cculpepper/ButterflyBadge/software/python_gif_to_code/trees.gif

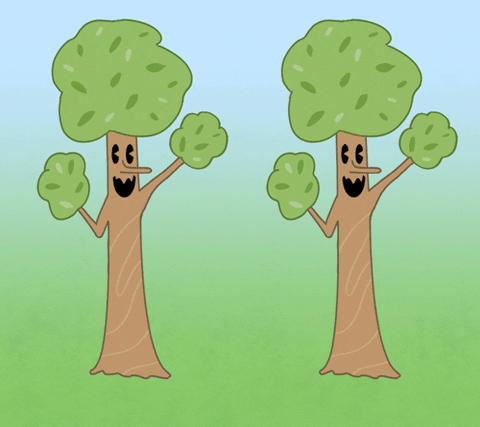
software/python_gif_to_code/trees.gif
