cculpepper/ButterflyBadge/software/python_gif_to_code/scrolling_rainbow.gif

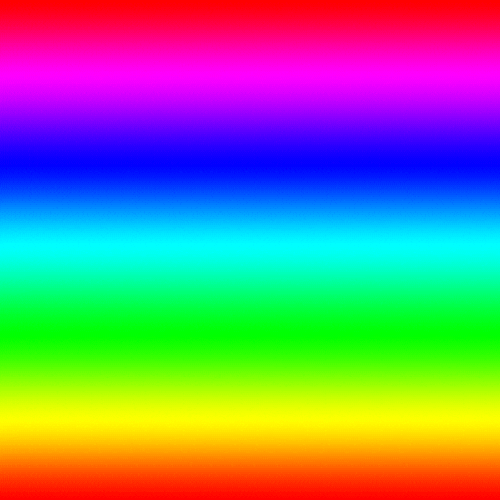
software/python_gif_to_code/scrolling_rainbow.gif
