cculpepper/ButterflyBadge/Hardware/StarboardWing/screenshotKegan.png

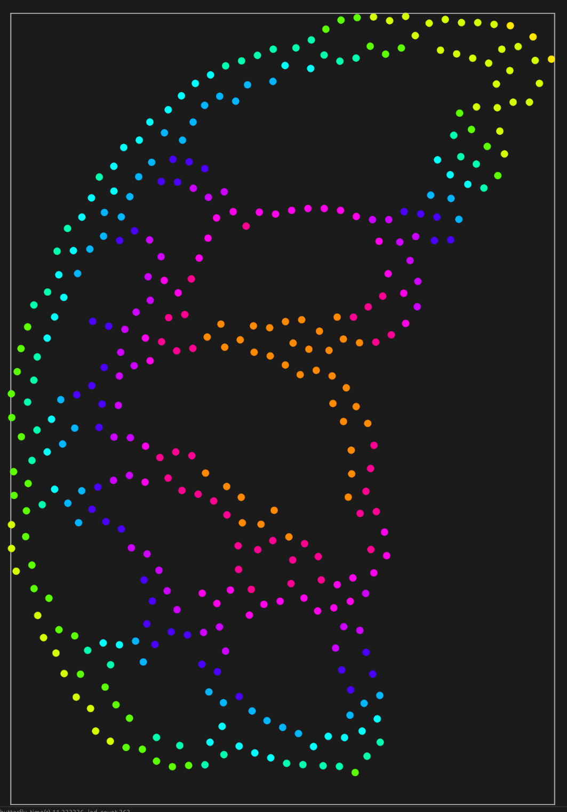
Hardware/StarboardWing/screenshotKegan.png
