cculpepper/ButterflyBadge/software/python_gif_to_code/bear.gif

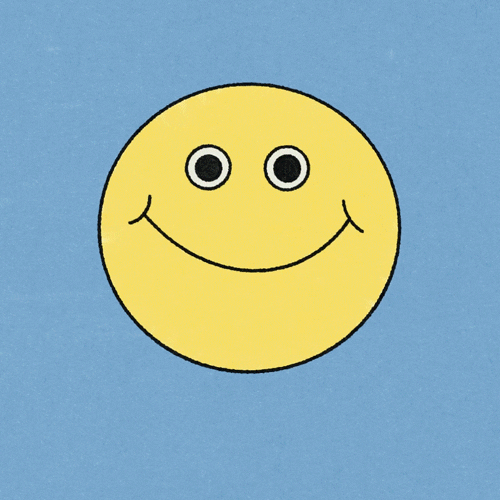
software/python_gif_to_code/bear.gif
