cculpepper/ButterflyBadge/software/python_gif_to_code/gif/myimage.gif

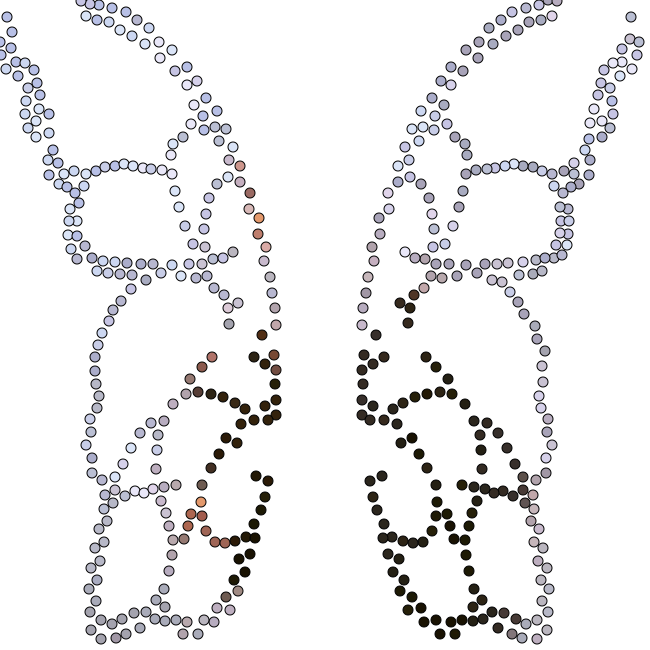
software/python_gif_to_code/gif/myimage.gif
