cculpepper/ButterflyBadge/Hardware/3D-Models/WholeBadge.FCStd

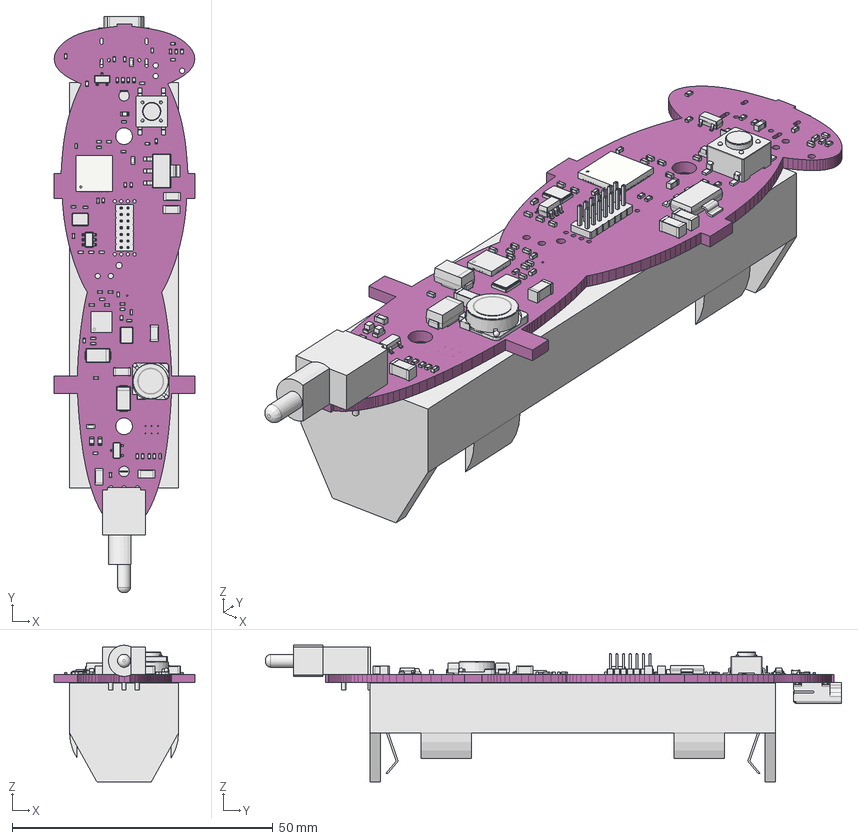
[picture p6: CAD file, 2022-10-18]
Hardware/3D-Models/WholeBadge.FCStd
26.9 x 110.4 x 26.2 mm
Pcb_931
R21_C_0402_1005Metric_38c94f1f1ba7 x 30
R19_R_0402_1005Metric_9ca80ee487fc x 22
D2_D_SMA_34cf3897dfc1 x 2
C42_C_0603_1608Metric_3f0e18eb3bdb x 3
SW3_Fillet_54ad2342c7e7
U5_SOT_223_0bc22c24d438
C44_C_1206_3216Metric_504a53cc2dd0 x 6
U6_QFN-20-1EP_4x4mm_Pitch0.5mm_3f7a39cb167c
L3_L_0402_1005Metric_7322f57e24a3 x 3
D516_LED_0603_1608Metric_23db4c450fc7 x 3
U8_SOT_23_1e3b1a0e5d43 x 2
U3_QFN_56_1EP_7x7mm_P04mm_EP32x32mm_92a982e71d8d
Y1_Crystal_SMD_3225-4Pin_3.2x2.5mm_5bc66405eca2 x 2
J4_PinHeader_2x07_P127mm_Vertical_bf31e59c633b
U9_SOT_23_6_c7a49d86fbfe
SW1_SW_SPST_PTS645_03fdbfd9ae36
L1_Sf㱟fd_sp_e828286b0ac3
BT1_MPD_BH_18650_PC2_17c3f7ae5d37
J1_USB_Mini-B_Lumberg_2486_01_Horizontal_f06c414dff7d
