cculpepper/ButterflyBadge/Hardware/3D-Models/StarboardWing.FCStd

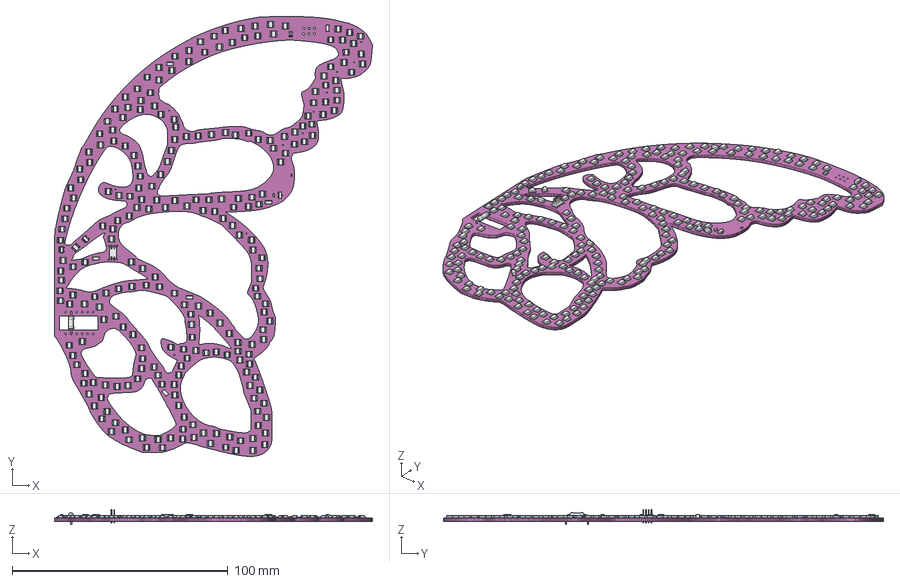
[picture p7: CAD file, 2022-10-22]
Hardware/3D-Models/StarboardWing.FCStd
147.4 x 203.9 x 7.00 mm
Pcb_1785
D136_LED_RGB_1210_62a520bec992 x 247
U4_SOT_23_5_fc069c77c7b4 x 2
C2_C_1206_3216Metric_b79cb4619a35 x 6
C3_C_0603_1608Metric_700197c864c6 x 3
U1_SOT_23_4b6a6773a716
J1_PinHeader_2x04_P127mm_Vertical_bbcf534692e7
J14_R_Axial_DIN0207_L63mm_D25mm_P1016mm_Horizontal_16070ee27b5d
C1_C_0402_1005Metric_dadc7bec6630
