cculpepper/ButterflyBadge/Hardware/wingHinge.FCStd

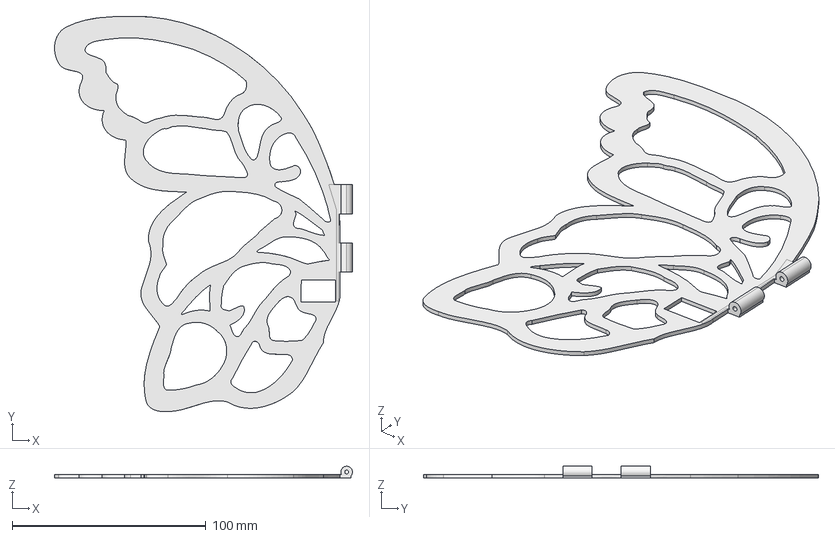
[picture p8: CAD file, 2022-12-04]
Hardware/wingHinge.FCStd
153.7 x 203.9 x 6.00 mm
