cculpepper/ButterflyBadge/Hardware/centerHinge.FCStd

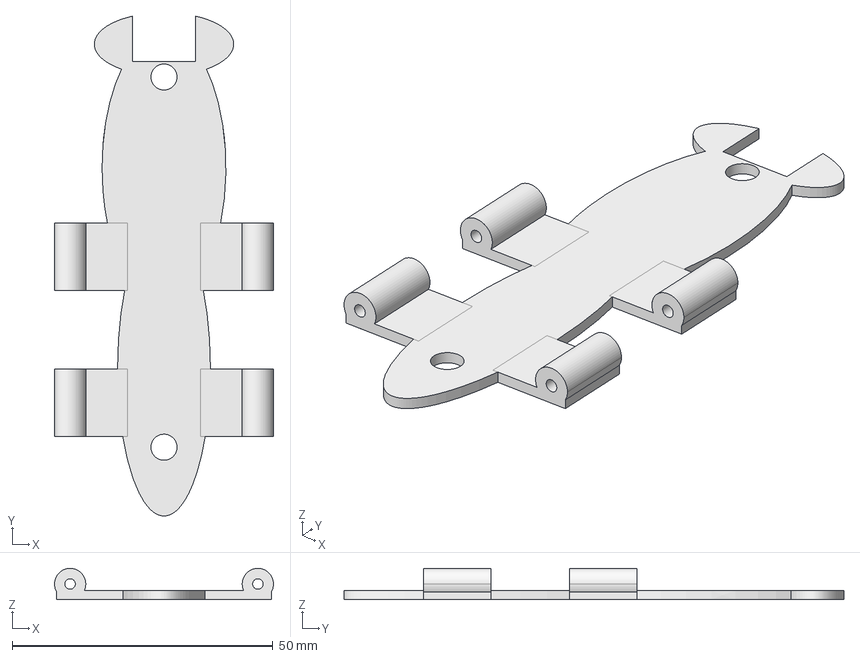
[picture p9: CAD file, 2022-12-04]
Hardware/centerHinge.FCStd
42.0 x 95.9 x 6.00 mm
