cculpepper/ButterflyBadge/(list of files, cad)

Other CAD files:
Hardware/hingeTestAssembly.FCStd
Hardware/ButterflyBadge/outline.FCStd
Hardware/3D-Models/centerWing.FCStd
Hardware/3D-Models/centerBoard.FCStd
Hardware/WingTest.FCStd
