cculpepper/ButterflyBadge/Hardware/PortWing/PortWing.kicad_pcb

## KiCad design Hardware/PortWing/PortWing.kicad_pcb (2022-10-20)

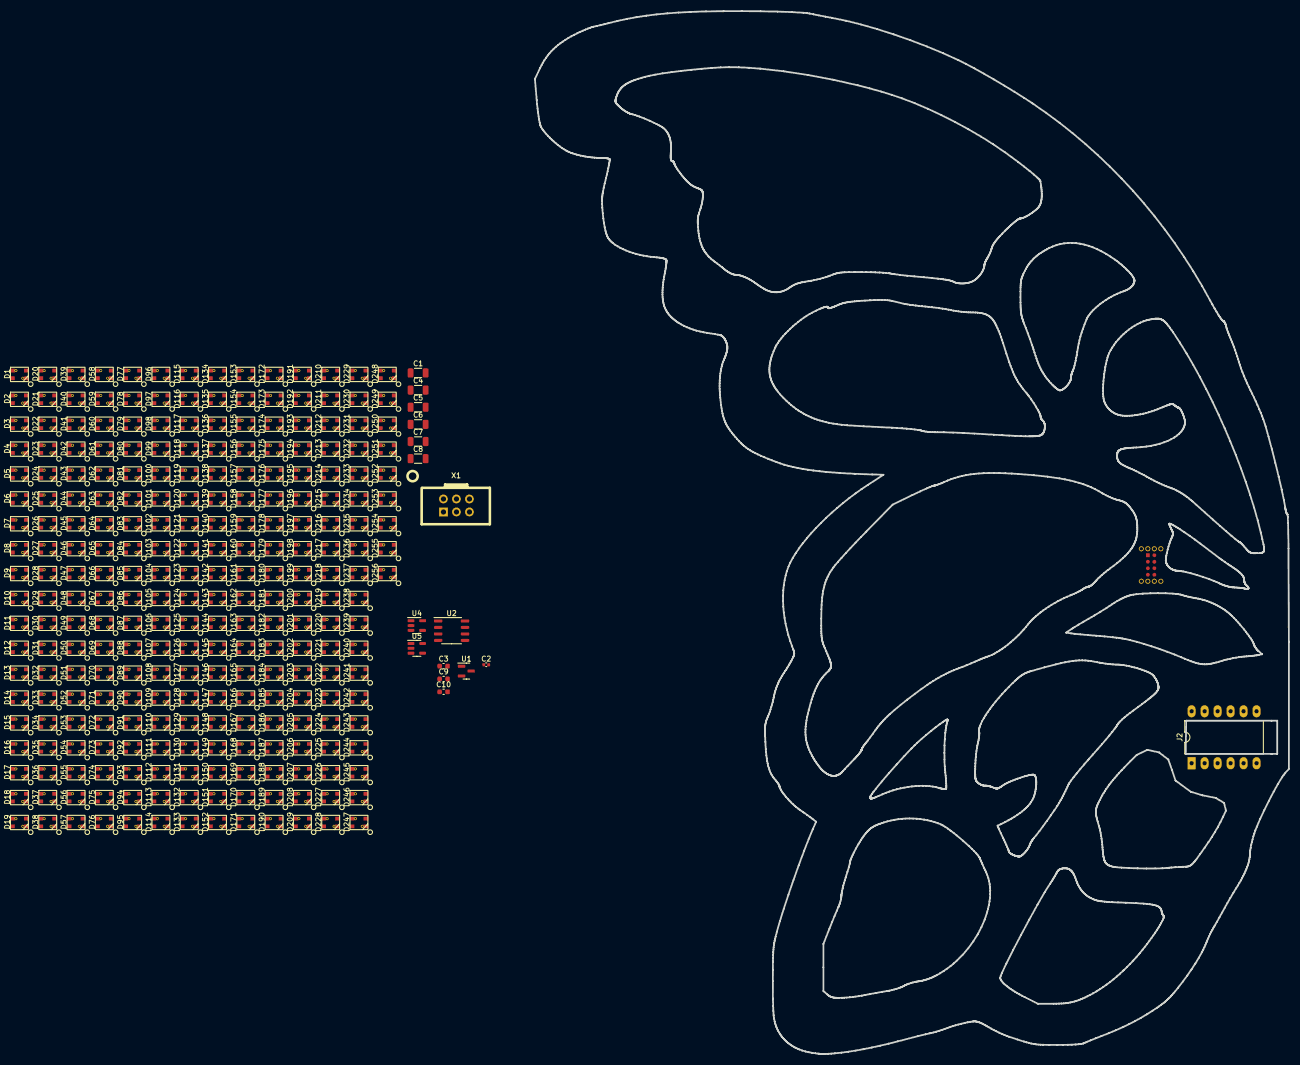
[picture p11: board PortWing.kicad_pcb from above]

Board: 2 copper layers, 147.4 x 203.9 mm, 273 parts (0 on the bottom side), 265 nets, no tracks yet.

Parts:
C1, C4, C5, C6, C7, C8: 22uF; C_1206_3216Metric
C2: 1uF; C_0402_1005Metric
C3, C9, C10: 10uF; C_0603_1608Metric
D1, D2, D3, D4, D5, D6, D7, D8, D9, D10, D11, D12, D13, D14, D15, D16, D17, D18, D19, D20, D21, D22, D23, D24, D25, D26, D27, D28, D29, D30, D31, D32, D33, D34, D35, D36, D37, D38, D39, D40, D41, D42, D43, D44, D45, D46, D47, D48, D49, D50, D51, D52, D53, D54, D55, D56, D57, D58, D59, D60, D61, D62, D63, D64, D65, D66, D67, D68, D69, D70, D71, D72, D73, D74, D75, D76, D77, D78, D79, D80, D81, D82, D83, D84, D85, D86, D87, D88, D89, D90, D91, D92, D93, D94, D95, D96, D97, D98, D99, D100, D101, D102, D103, D104, D105, D106, D107, D108, D109, D110, D111, D112, D113, D114, D115, D116, D117, D118, D119, D120, D121, D122, D123, D124, D125, D126, D127, D128, D129, D130, D131, D132, D133, D134, D135, D136, D137, D138, D139, D140, D141, D142, D143, D144, D145, D146, D147, D148, D149, D150, D151, D152, D153, D154, D155, D156, D157, D158, D159, D160, D161, D162, D163, D164, D165, D166, D167, D168, D169, D170, D171, D172, D173, D174, D175, D176, D177, D178, D179, D180, D181, D182, D183, D184, D185, D186, D187, D188, D189, D190, D191, D192, D193, D194, D195, D196, D197, D198, D199, D200, D201, D202, D203, D204, D205, D206, D207, D208, D209, D210, D211, D212, D213, D214, D215, D216, D217, D218, D219, D220, D221, D222, D223, D224, D225, D226, D227, D228, D229, D230, D231, D232, D233, D234, D235, D236, D237, D238, D239, D240, D241, D242, D243, D244, D245, D246, D247, D248, D249, D250, D251, D252, D253, D254, D255, D256: SK6812; XL-3528RGBW
J1: Conn_02x04_Odd_Even; FlatFlexWingConnector-WingPCBSide
J2: Conn_02x06_Counter_Clockwise; DIP-12_W10.16mm_LongPads
U1: XC6206PxxxMR; SOT-23
U2: SOP-8_3.9x4.9mm_P1.27mm
U4, U5: SN74LV1T34DBV; SOT-23-5
X1: Badgelife_sao_connector_v169bis; Badgelife-SAOv169-BADGE-2x3

Connections:
/3V3: C2.1, C3.1, C9.1, C10.1, U1.2 (VO), U2.1 (V_EH), U2.8 (VCC), X1.1 (VCC)
/5V: C1.1, C4.1, C5.1, C6.1, C7.1, C8.1, D1.3 (VDD), D2.3 (VDD), D3.3 (VDD), D4.3 (VDD), D5.3 (VDD), D6.3 (VDD), D7.3 (VDD), D8.3 (VDD), D9.3 (VDD), D10.3 (VDD), D11.3 (VDD), D12.3 (VDD), D13.3 (VDD), D14.3 (VDD), D15.3 (VDD), D16.3 (VDD), D17.3 (VDD), D18.3 (VDD), D19.3 (VDD), D20.3 (VDD), D21.3 (VDD), D22.3 (VDD), D23.3 (VDD), D24.3 (VDD), D25.3 (VDD), D26.3 (VDD), D27.3 (VDD), D28.3 (VDD), D29.3 (VDD), D30.3 (VDD), D31.3 (VDD), D32.3 (VDD), D33.3 (VDD), D34.3 (VDD), D35.3 (VDD), D36.3 (VDD), D37.3 (VDD), D38.3 (VDD), D39.3 (VDD), D40.3 (VDD), D41.3 (VDD), D42.3 (VDD), D43.3 (VDD), D44.3 (VDD), D45.3 (VDD), D46.3 (VDD), D47.3 (VDD), D48.3 (VDD), D49.3 (VDD), D50.3 (VDD), D51.3 (VDD), D52.3 (VDD), D53.3 (VDD), D54.3 (VDD), D55.3 (VDD), D56.3 (VDD), D57.3 (VDD), D58.3 (VDD), D59.3 (VDD), D60.3 (VDD), D61.3 (VDD), D62.3 (VDD), D63.3 (VDD), D64.3 (VDD), D65.3 (VDD), D66.3 (VDD), D67.3 (VDD), D68.3 (VDD), D69.3 (VDD), D70.3 (VDD), D71.3 (VDD), D72.3 (VDD), D73.3 (VDD), D74.3 (VDD), D75.3 (VDD), D76.3 (VDD), D77.3 (VDD), D78.3 (VDD), D79.3 (VDD), D80.3 (VDD), D81.3 (VDD), D82.3 (VDD), D83.3 (VDD), D84.3 (VDD), D85.3 (VDD), D86.3 (VDD), D87.3 (VDD), D88.3 (VDD), D89.3 (VDD), D90.3 (VDD), D91.3 (VDD), D92.3 (VDD), D93.3 (VDD), D94.3 (VDD), D95.3 (VDD), D96.3 (VDD), D97.3 (VDD), D98.3 (VDD), D99.3 (VDD), D100.3 (VDD), D101.3 (VDD), D102.3 (VDD), D103.3 (VDD), D104.3 (VDD), D105.3 (VDD), D106.3 (VDD), D107.3 (VDD), D108.3 (VDD), D109.3 (VDD), D110.3 (VDD), D111.3 (VDD), D112.3 (VDD), D113.3 (VDD), D114.3 (VDD), D115.3 (VDD), D116.3 (VDD), D117.3 (VDD), D118.3 (VDD), D119.3 (VDD), D120.3 (VDD), D121.3 (VDD), D122.3 (VDD), D123.3 (VDD), D124.3 (VDD), D125.3 (VDD), D126.3 (VDD), D127.3 (VDD), D128.3 (VDD), D129.3 (VDD), D130.3 (VDD), D131.3 (VDD), D132.3 (VDD), D133.3 (VDD), D134.3 (VDD), D135.3 (VDD), D136.3 (VDD), D137.3 (VDD), D138.3 (VDD), D139.3 (VDD), D140.3 (VDD), D141.3 (VDD), D142.3 (VDD), D143.3 (VDD), D144.3 (VDD), D145.3 (VDD), D146.3 (VDD), D147.3 (VDD), D148.3 (VDD), D149.3 (VDD), D150.3 (VDD), D151.3 (VDD), D152.3 (VDD), D153.3 (VDD), D154.3 (VDD), D155.3 (VDD), D156.3 (VDD), D157.3 (VDD), D158.3 (VDD), D159.3 (VDD), D160.3 (VDD), D161.3 (VDD), D162.3 (VDD), D163.3 (VDD), D164.3 (VDD), D165.3 (VDD), D166.3 (VDD), D167.3 (VDD), D168.3 (VDD), D169.3 (VDD), D170.3 (VDD), D171.3 (VDD), D172.3 (VDD), D173.3 (VDD), D174.3 (VDD), D175.3 (VDD), D176.3 (VDD), D177.3 (VDD), D178.3 (VDD), D179.3 (VDD), D180.3 (VDD), D181.3 (VDD), D182.3 (VDD), D183.3 (VDD), D184.3 (VDD), D185.3 (VDD), D186.3 (VDD), D187.3 (VDD), D188.3 (VDD), D189.3 (VDD), D190.3 (VDD), D191.3 (VDD), D192.3 (VDD), D193.3 (VDD), D194.3 (VDD), D195.3 (VDD), D196.3 (VDD), D197.3 (VDD), D198.3 (VDD), D199.3 (VDD), D200.3 (VDD), D201.3 (VDD), D202.3 (VDD), D203.3 (VDD), D204.3 (VDD), D205.3 (VDD), D206.3 (VDD), D207.3 (VDD), D208.3 (VDD), D209.3 (VDD), D210.3 (VDD), D211.3 (VDD), D212.3 (VDD), D213.3 (VDD), D214.3 (VDD), D215.3 (VDD), D216.3 (VDD), D217.3 (VDD), D218.3 (VDD), D219.3 (VDD), D220.3 (VDD), D221.3 (VDD), D222.3 (VDD), D223.3 (VDD), D224.3 (VDD), D225.3 (VDD), D226.3 (VDD), D227.3 (VDD), D228.3 (VDD), D229.3 (VDD), D230.3 (VDD), D231.3 (VDD), D232.3 (VDD), D233.3 (VDD), D234.3 (VDD), D235.3 (VDD), D236.3 (VDD), D237.3 (VDD), D238.3 (VDD), D239.3 (VDD), D240.3 (VDD), D241.3 (VDD), D242.3 (VDD), D243.3 (VDD), D244.3 (VDD), D245.3 (VDD), D246.3 (VDD), D247.3 (VDD), D248.3 (VDD), D249.3 (VDD), D250.3 (VDD), D251.3 (VDD), D252.3 (VDD), D253.3 (VDD), D254.3 (VDD), D255.3 (VDD), D256.3 (VDD), J1.1, U1.3 (VI), U4.5 (VCC), U5.5 (VCC)
/GND: C1.2, C2.2, C3.2, C4.2, C5.2, C6.2, C7.2, C8.2, C9.2, C10.2, D1.1 (VSS), D2.1 (VSS), D3.1 (VSS), D4.1 (VSS), D5.1 (VSS), D6.1 (VSS), D7.1 (VSS), D8.1 (VSS), D9.1 (VSS), D10.1 (VSS), D11.1 (VSS), D12.1 (VSS), D13.1 (VSS), D14.1 (VSS), D15.1 (VSS), D16.1 (VSS), D17.1 (VSS), D18.1 (VSS), D19.1 (VSS), D20.1 (VSS), D21.1 (VSS), D22.1 (VSS), D23.1 (VSS), D24.1 (VSS), D25.1 (VSS), D26.1 (VSS), D27.1 (VSS), D28.1 (VSS), D29.1 (VSS), D30.1 (VSS), D31.1 (VSS), D32.1 (VSS), D33.1 (VSS), D34.1 (VSS), D35.1 (VSS), D36.1 (VSS), D37.1 (VSS), D38.1 (VSS), D39.1 (VSS), D40.1 (VSS), D41.1 (VSS), D42.1 (VSS), D43.1 (VSS), D44.1 (VSS), D45.1 (VSS), D46.1 (VSS), D47.1 (VSS), D48.1 (VSS), D49.1 (VSS), D50.1 (VSS), D51.1 (VSS), D52.1 (VSS), D53.1 (VSS), D54.1 (VSS), D55.1 (VSS), D56.1 (VSS), D57.1 (VSS), D58.1 (VSS), D59.1 (VSS), D60.1 (VSS), D61.1 (VSS), D62.1 (VSS), D63.1 (VSS), D64.1 (VSS), D65.1 (VSS), D66.1 (VSS), D67.1 (VSS), D68.1 (VSS), D69.1 (VSS), D70.1 (VSS), D71.1 (VSS), D72.1 (VSS), D73.1 (VSS), D74.1 (VSS), D75.1 (VSS), D76.1 (VSS), D77.1 (VSS), D78.1 (VSS), D79.1 (VSS), D80.1 (VSS), D81.1 (VSS), D82.1 (VSS), D83.1 (VSS), D84.1 (VSS), D85.1 (VSS), D86.1 (VSS), D87.1 (VSS), D88.1 (VSS), D89.1 (VSS), D90.1 (VSS), D91.1 (VSS), D92.1 (VSS), D93.1 (VSS), D94.1 (VSS), D95.1 (VSS), D96.1 (VSS), D97.1 (VSS), D98.1 (VSS), D99.1 (VSS), D100.1 (VSS), D101.1 (VSS), D102.1 (VSS), D103.1 (VSS), D104.1 (VSS), D105.1 (VSS), D106.1 (VSS), D107.1 (VSS), D108.1 (VSS), D109.1 (VSS), D110.1 (VSS), D111.1 (VSS), D112.1 (VSS), D113.1 (VSS), D114.1 (VSS), D115.1 (VSS), D116.1 (VSS), D117.1 (VSS), D118.1 (VSS), D119.1 (VSS), D120.1 (VSS), D121.1 (VSS), D122.1 (VSS), D123.1 (VSS), D124.1 (VSS), D125.1 (VSS), D126.1 (VSS), D127.1 (VSS), D128.1 (VSS), D129.1 (VSS), D130.1 (VSS), D131.1 (VSS), D132.1 (VSS), D133.1 (VSS), D134.1 (VSS), D135.1 (VSS), D136.1 (VSS), D137.1 (VSS), D138.1 (VSS), D139.1 (VSS), D140.1 (VSS), D141.1 (VSS), D142.1 (VSS), D143.1 (VSS), D144.1 (VSS), D145.1 (VSS), D146.1 (VSS), D147.1 (VSS), D148.1 (VSS), D149.1 (VSS), D150.1 (VSS), D151.1 (VSS), D152.1 (VSS), D153.1 (VSS), D154.1 (VSS), D155.1 (VSS), D156.1 (VSS), D157.1 (VSS), D158.1 (VSS), D159.1 (VSS), D160.1 (VSS), D161.1 (VSS), D162.1 (VSS), D163.1 (VSS), D164.1 (VSS), D165.1 (VSS), D166.1 (VSS), D167.1 (VSS), D168.1 (VSS), D169.1 (VSS), D170.1 (VSS), D171.1 (VSS), D172.1 (VSS), D173.1 (VSS), D174.1 (VSS), D175.1 (VSS), D176.1 (VSS), D177.1 (VSS), D178.1 (VSS), D179.1 (VSS), D180.1 (VSS), D181.1 (VSS), D182.1 (VSS), D183.1 (VSS), D184.1 (VSS), D185.1 (VSS), D186.1 (VSS), D187.1 (VSS), D188.1 (VSS), D189.1 (VSS), D190.1 (VSS), D191.1 (VSS), D192.1 (VSS), D193.1 (VSS), D194.1 (VSS), D195.1 (VSS), D196.1 (VSS), D197.1 (VSS), D198.1 (VSS), D199.1 (VSS), D200.1 (VSS), D201.1 (VSS), D202.1 (VSS), D203.1 (VSS), D204.1 (VSS), D205.1 (VSS), D206.1 (VSS), D207.1 (VSS), D208.1 (VSS), D209.1 (VSS), D210.1 (VSS), D211.1 (VSS), D212.1 (VSS), D213.1 (VSS), D214.1 (VSS), D215.1 (VSS), D216.1 (VSS), D217.1 (VSS), D218.1 (VSS), D219.1 (VSS), D220.1 (VSS), D221.1 (VSS), D222.1 (VSS), D223.1 (VSS), D224.1 (VSS), D225.1 (VSS), D226.1 (VSS), D227.1 (VSS), D228.1 (VSS), D229.1 (VSS), D230.1 (VSS), D231.1 (VSS), D232.1 (VSS), D233.1 (VSS), D234.1 (VSS), D235.1 (VSS), D236.1 (VSS), D237.1 (VSS), D238.1 (VSS), D239.1 (VSS), D240.1 (VSS), D241.1 (VSS), D242.1 (VSS), D243.1 (VSS), D244.1 (VSS), D245.1 (VSS), D246.1 (VSS), D247.1 (VSS), D248.1 (VSS), D249.1 (VSS), D250.1 (VSS), D251.1 (VSS), D252.1 (VSS), D253.1 (VSS), D254.1 (VSS), D255.1 (VSS), D256.1 (VSS), J1.3, U1.1 (GND), U2.4 (VSS), U4.3 (GND), U5.3 (GND), X1.2 (GND)
/NFC_MSG: J1.8, U2.7 (GP0), X1.6 (GPIO2)
/PORT_GP0: J1.6, X1.5 (GPIO1)
/PORT_LED_1: J1.2, U4.2 (A)
/PORT_LED_2: J1.4, U5.2 (A)
/SCL: J1.5, U2.6 (SCL), X1.4 (SCL)
/SDA: J1.7, U2.5 (SDA), X1.3 (SDA)
unnamed: D1.2 (DIN), U4.4 (Y)
unnamed: D1.4 (DOUT), D2.2 (DIN)
unnamed: D2.4 (DOUT), D3.2 (DIN)
unnamed: D3.4 (DOUT), D4.2 (DIN)
unnamed: D4.4 (DOUT), D5.2 (DIN)
unnamed: D5.4 (DOUT), D6.2 (DIN)
unnamed: D6.4 (DOUT), D7.2 (DIN)
unnamed: D7.4 (DOUT), D8.2 (DIN)
unnamed: D8.4 (DOUT), D9.2 (DIN)
unnamed: D9.4 (DOUT), D10.2 (DIN)
unnamed: D10.4 (DOUT), D11.2 (DIN)
unnamed: D11.4 (DOUT), D12.2 (DIN)
unnamed: D12.4 (DOUT), D13.2 (DIN)
unnamed: D13.4 (DOUT), D14.2 (DIN)
unnamed: D14.4 (DOUT), D15.2 (DIN)
unnamed: D15.4 (DOUT), D16.2 (DIN)
unnamed: D16.4 (DOUT), D17.2 (DIN)
unnamed: D17.4 (DOUT), D18.2 (DIN)
unnamed: D18.4 (DOUT), D19.2 (DIN)
unnamed: D19.4 (DOUT), D20.2 (DIN)
unnamed: D20.4 (DOUT), D21.2 (DIN)
unnamed: D21.4 (DOUT), D22.2 (DIN)
unnamed: D22.4 (DOUT), D23.2 (DIN)
unnamed: D23.4 (DOUT), D24.2 (DIN)
unnamed: D24.4 (DOUT), D25.2 (DIN)
unnamed: D25.4 (DOUT), D26.2 (DIN)
unnamed: D26.4 (DOUT), D27.2 (DIN)
unnamed: D27.4 (DOUT), D28.2 (DIN)
unnamed: D28.4 (DOUT), D29.2 (DIN)
unnamed: D29.4 (DOUT), D30.2 (DIN)
unnamed: D30.4 (DOUT), D31.2 (DIN)
unnamed: D31.4 (DOUT), D32.2 (DIN)
unnamed: D32.4 (DOUT), D33.2 (DIN)
unnamed: D33.4 (DOUT), D34.2 (DIN)
unnamed: D34.4 (DOUT), D35.2 (DIN)
unnamed: D35.4 (DOUT), D36.2 (DIN)
unnamed: D36.4 (DOUT), D37.2 (DIN)
unnamed: D37.4 (DOUT), D38.2 (DIN)
unnamed: D38.4 (DOUT), D39.2 (DIN)
unnamed: D39.4 (DOUT), D40.2 (DIN)
unnamed: D40.4 (DOUT), D41.2 (DIN)
unnamed: D41.4 (DOUT), D42.2 (DIN)
unnamed: D42.4 (DOUT), D43.2 (DIN)
unnamed: D43.4 (DOUT), D44.2 (DIN)
unnamed: D44.4 (DOUT), D45.2 (DIN)
unnamed: D45.4 (DOUT), D46.2 (DIN)
unnamed: D46.4 (DOUT), D47.2 (DIN)
unnamed: D47.4 (DOUT), D48.2 (DIN)
unnamed: D48.4 (DOUT), D49.2 (DIN)
unnamed: D49.4 (DOUT), D50.2 (DIN)
unnamed: D50.4 (DOUT), D51.2 (DIN)
unnamed: D51.4 (DOUT), D52.2 (DIN)
unnamed: D52.4 (DOUT), D53.2 (DIN)
unnamed: D53.4 (DOUT), D54.2 (DIN)
unnamed: D54.4 (DOUT), D55.2 (DIN)
unnamed: D55.4 (DOUT), D56.2 (DIN)
unnamed: D56.4 (DOUT), D57.2 (DIN)
unnamed: D57.4 (DOUT), D58.2 (DIN)
unnamed: D58.4 (DOUT), D59.2 (DIN)
unnamed: D59.4 (DOUT), D60.2 (DIN)
unnamed: D60.4 (DOUT), D61.2 (DIN)
unnamed: D61.4 (DOUT), D62.2 (DIN)
unnamed: D62.4 (DOUT), D63.2 (DIN)
unnamed: D63.4 (DOUT), D64.2 (DIN)
unnamed: D64.4 (DOUT), D65.2 (DIN)
unnamed: D65.4 (DOUT), D66.2 (DIN)
unnamed: D66.4 (DOUT), D67.2 (DIN)
unnamed: D67.4 (DOUT), D68.2 (DIN)
unnamed: D68.4 (DOUT), D69.2 (DIN)
unnamed: D69.4 (DOUT), D70.2 (DIN)
unnamed: D70.4 (DOUT), D71.2 (DIN)
unnamed: D71.4 (DOUT), D72.2 (DIN)
unnamed: D72.4 (DOUT), D73.2 (DIN)
unnamed: D73.4 (DOUT), D74.2 (DIN)
unnamed: D74.4 (DOUT), D75.2 (DIN)
unnamed: D75.4 (DOUT), D76.2 (DIN)
unnamed: D76.4 (DOUT), D77.2 (DIN)
unnamed: D77.4 (DOUT), D78.2 (DIN)
unnamed: D78.4 (DOUT), D79.2 (DIN)
unnamed: D79.4 (DOUT), D80.2 (DIN)
unnamed: D80.4 (DOUT), D81.2 (DIN)
unnamed: D81.4 (DOUT), D82.2 (DIN)
unnamed: D82.4 (DOUT), D83.2 (DIN)
unnamed: D83.4 (DOUT), D84.2 (DIN)
unnamed: D84.4 (DOUT), D85.2 (DIN)
unnamed: D85.4 (DOUT), D86.2 (DIN)
unnamed: D86.4 (DOUT), D87.2 (DIN)
unnamed: D87.4 (DOUT), D88.2 (DIN)
unnamed: D88.4 (DOUT), D89.2 (DIN)
unnamed: D89.4 (DOUT), D90.2 (DIN)
unnamed: D90.4 (DOUT), D91.2 (DIN)
unnamed: D91.4 (DOUT), D92.2 (DIN)
unnamed: D92.4 (DOUT), D93.2 (DIN)
unnamed: D93.4 (DOUT), D94.2 (DIN)
unnamed: D94.4 (DOUT), D95.2 (DIN)
unnamed: D95.4 (DOUT), D96.2 (DIN)
unnamed: D96.4 (DOUT), D97.2 (DIN)
unnamed: D97.4 (DOUT), D98.2 (DIN)
unnamed: D98.4 (DOUT), D99.2 (DIN)
unnamed: D99.4 (DOUT), D100.2 (DIN)
unnamed: D100.4 (DOUT), D101.2 (DIN)
unnamed: D101.4 (DOUT), D102.2 (DIN)
unnamed: D102.4 (DOUT), D103.2 (DIN)
unnamed: D103.4 (DOUT), D104.2 (DIN)
unnamed: D104.4 (DOUT), D105.2 (DIN)
unnamed: D105.4 (DOUT), D106.2 (DIN)
unnamed: D106.4 (DOUT), D107.2 (DIN)
unnamed: D107.4 (DOUT), D108.2 (DIN)
unnamed: D108.4 (DOUT), D109.2 (DIN)
unnamed: D109.4 (DOUT), D110.2 (DIN)
unnamed: D110.4 (DOUT), D111.2 (DIN)
unnamed: D111.4 (DOUT), D112.2 (DIN)
unnamed: D112.4 (DOUT), D113.2 (DIN)
unnamed: D113.4 (DOUT), D114.2 (DIN)
unnamed: D114.4 (DOUT), D115.2 (DIN)
unnamed: D115.4 (DOUT), D116.2 (DIN)
unnamed: D116.4 (DOUT), D117.2 (DIN)
unnamed: D117.4 (DOUT), D118.2 (DIN)
unnamed: D118.4 (DOUT), D119.2 (DIN)
unnamed: D119.4 (DOUT), D120.2 (DIN)
unnamed: D120.4 (DOUT), D121.2 (DIN)
unnamed: D121.4 (DOUT), D122.2 (DIN)
unnamed: D122.4 (DOUT), D123.2 (DIN)
unnamed: D123.4 (DOUT), D124.2 (DIN)
unnamed: D124.4 (DOUT), D125.2 (DIN)
unnamed: D125.4 (DOUT), D126.2 (DIN)
unnamed: D126.4 (DOUT), D127.2 (DIN)
unnamed: D127.4 (DOUT), D128.2 (DIN)
unnamed: D129.2 (DIN), U5.4 (Y)
unnamed: D129.4 (DOUT), D130.2 (DIN)
unnamed: D130.4 (DOUT), D131.2 (DIN)
unnamed: D131.4 (DOUT), D132.2 (DIN)
unnamed: D132.4 (DOUT), D133.2 (DIN)
unnamed: D133.4 (DOUT), D134.2 (DIN)
unnamed: D134.4 (DOUT), D135.2 (DIN)
unnamed: D135.4 (DOUT), D136.2 (DIN)
unnamed: D136.4 (DOUT), D137.2 (DIN)
unnamed: D137.4 (DOUT), D138.2 (DIN)
unnamed: D138.4 (DOUT), D139.2 (DIN)
unnamed: D139.4 (DOUT), D140.2 (DIN)
unnamed: D140.4 (DOUT), D141.2 (DIN)
unnamed: D141.4 (DOUT), D142.2 (DIN)
unnamed: D142.4 (DOUT), D143.2 (DIN)
unnamed: D143.4 (DOUT), D144.2 (DIN)
unnamed: D144.4 (DOUT), D145.2 (DIN)
unnamed: D145.4 (DOUT), D146.2 (DIN)
unnamed: D146.4 (DOUT), D147.2 (DIN)
unnamed: D147.4 (DOUT), D148.2 (DIN)
unnamed: D148.4 (DOUT), D149.2 (DIN)
unnamed: D149.4 (DOUT), D150.2 (DIN)
unnamed: D150.4 (DOUT), D151.2 (DIN)
unnamed: D151.4 (DOUT), D152.2 (DIN)
unnamed: D152.4 (DOUT), D153.2 (DIN)
unnamed: D153.4 (DOUT), D154.2 (DIN)
unnamed: D154.4 (DOUT), D155.2 (DIN)
unnamed: D155.4 (DOUT), D156.2 (DIN)
unnamed: D156.4 (DOUT), D157.2 (DIN)
unnamed: D157.4 (DOUT), D158.2 (DIN)
unnamed: D158.4 (DOUT), D159.2 (DIN)
unnamed: D159.4 (DOUT), D160.2 (DIN)
unnamed: D160.4 (DOUT), D161.2 (DIN)
unnamed: D161.4 (DOUT), D162.2 (DIN)
unnamed: D162.4 (DOUT), D163.2 (DIN)
unnamed: D163.4 (DOUT), D164.2 (DIN)
unnamed: D164.4 (DOUT), D165.2 (DIN)
unnamed: D165.4 (DOUT), D166.2 (DIN)
unnamed: D166.4 (DOUT), D167.2 (DIN)
unnamed: D167.4 (DOUT), D168.2 (DIN)
unnamed: D168.4 (DOUT), D169.2 (DIN)
unnamed: D169.4 (DOUT), D170.2 (DIN)
unnamed: D170.4 (DOUT), D171.2 (DIN)
unnamed: D171.4 (DOUT), D172.2 (DIN)
unnamed: D172.4 (DOUT), D173.2 (DIN)
unnamed: D173.4 (DOUT), D174.2 (DIN)
unnamed: D174.4 (DOUT), D175.2 (DIN)
unnamed: D175.4 (DOUT), D176.2 (DIN)
unnamed: D176.4 (DOUT), D177.2 (DIN)
unnamed: D177.4 (DOUT), D178.2 (DIN)
unnamed: D178.4 (DOUT), D179.2 (DIN)
unnamed: D179.4 (DOUT), D180.2 (DIN)
unnamed: D180.4 (DOUT), D181.2 (DIN)
unnamed: D181.4 (DOUT), D182.2 (DIN)
unnamed: D182.4 (DOUT), D183.2 (DIN)
unnamed: D183.4 (DOUT), D184.2 (DIN)
unnamed: D184.4 (DOUT), D185.2 (DIN)
unnamed: D185.4 (DOUT), D186.2 (DIN)
unnamed: D186.4 (DOUT), D187.2 (DIN)
unnamed: D187.4 (DOUT), D188.2 (DIN)
unnamed: D188.4 (DOUT), D189.2 (DIN)
unnamed: D189.4 (DOUT), D190.2 (DIN)
unnamed: D190.4 (DOUT), D191.2 (DIN)
unnamed: D191.4 (DOUT), D192.2 (DIN)
unnamed: D192.4 (DOUT), D193.2 (DIN)
unnamed: D193.4 (DOUT), D194.2 (DIN)
unnamed: D194.4 (DOUT), D195.2 (DIN)
unnamed: D195.4 (DOUT), D196.2 (DIN)
unnamed: D196.4 (DOUT), D197.2 (DIN)
unnamed: D197.4 (DOUT), D198.2 (DIN)
unnamed: D198.4 (DOUT), D199.2 (DIN)
unnamed: D199.4 (DOUT), D200.2 (DIN)
unnamed: D200.4 (DOUT), D201.2 (DIN)
unnamed: D201.4 (DOUT), D202.2 (DIN)
unnamed: D202.4 (DOUT), D203.2 (DIN)
unnamed: D203.4 (DOUT), D204.2 (DIN)
unnamed: D204.4 (DOUT), D205.2 (DIN)
unnamed: D205.4 (DOUT), D206.2 (DIN)
unnamed: D206.4 (DOUT), D207.2 (DIN)
unnamed: D207.4 (DOUT), D208.2 (DIN)
unnamed: D208.4 (DOUT), D209.2 (DIN)
unnamed: D209.4 (DOUT), D210.2 (DIN)
unnamed: D210.4 (DOUT), D211.2 (DIN)
unnamed: D211.4 (DOUT), D212.2 (DIN)
unnamed: D212.4 (DOUT), D213.2 (DIN)
unnamed: D213.4 (DOUT), D214.2 (DIN)
unnamed: D214.4 (DOUT), D215.2 (DIN)
unnamed: D215.4 (DOUT), D216.2 (DIN)
unnamed: D216.4 (DOUT), D217.2 (DIN)
unnamed: D217.4 (DOUT), D218.2 (DIN)
unnamed: D218.4 (DOUT), D219.2 (DIN)
unnamed: D219.4 (DOUT), D220.2 (DIN)
unnamed: D220.4 (DOUT), D221.2 (DIN)
unnamed: D221.4 (DOUT), D222.2 (DIN)
unnamed: D222.4 (DOUT), D223.2 (DIN)
unnamed: D223.4 (DOUT), D224.2 (DIN)
unnamed: D224.4 (DOUT), D225.2 (DIN)
unnamed: D225.4 (DOUT), D226.2 (DIN)
unnamed: D226.4 (DOUT), D227.2 (DIN)
unnamed: D227.4 (DOUT), D228.2 (DIN)
unnamed: D228.4 (DOUT), D229.2 (DIN)
unnamed: D229.4 (DOUT), D230.2 (DIN)
unnamed: D230.4 (DOUT), D231.2 (DIN)
unnamed: D231.4 (DOUT), D232.2 (DIN)
unnamed: D232.4 (DOUT), D233.2 (DIN)
unnamed: D233.4 (DOUT), D234.2 (DIN)
unnamed: D234.4 (DOUT), D235.2 (DIN)
unnamed: D235.4 (DOUT), D236.2 (DIN)
unnamed: D236.4 (DOUT), D237.2 (DIN)
unnamed: D237.4 (DOUT), D238.2 (DIN)
unnamed: D238.4 (DOUT), D239.2 (DIN)
unnamed: D239.4 (DOUT), D240.2 (DIN)
unnamed: D240.4 (DOUT), D241.2 (DIN)
unnamed: D241.4 (DOUT), D242.2 (DIN)
unnamed: D242.4 (DOUT), D243.2 (DIN)
unnamed: D243.4 (DOUT), D244.2 (DIN)
unnamed: D244.4 (DOUT), D245.2 (DIN)
unnamed: D245.4 (DOUT), D246.2 (DIN)
unnamed: D246.4 (DOUT), D247.2 (DIN)
unnamed: D247.4 (DOUT), D248.2 (DIN)
unnamed: D248.4 (DOUT), D249.2 (DIN)
unnamed: D249.4 (DOUT), D250.2 (DIN)
unnamed: D250.4 (DOUT), D251.2 (DIN)
unnamed: D251.4 (DOUT), D252.2 (DIN)
unnamed: D252.4 (DOUT), D253.2 (DIN)
unnamed: D253.4 (DOUT), D254.2 (DIN)
unnamed: D254.4 (DOUT), D255.2 (DIN)
unnamed: D255.4 (DOUT), D256.2 (DIN)
