cculpepper/ButterflyBadge/Hardware/ButterflyBadge/ButterflyBadge.kicad_pcb

## KiCad design Hardware/ButterflyBadge/ButterflyBadge.kicad_pcb (2022-10-18)

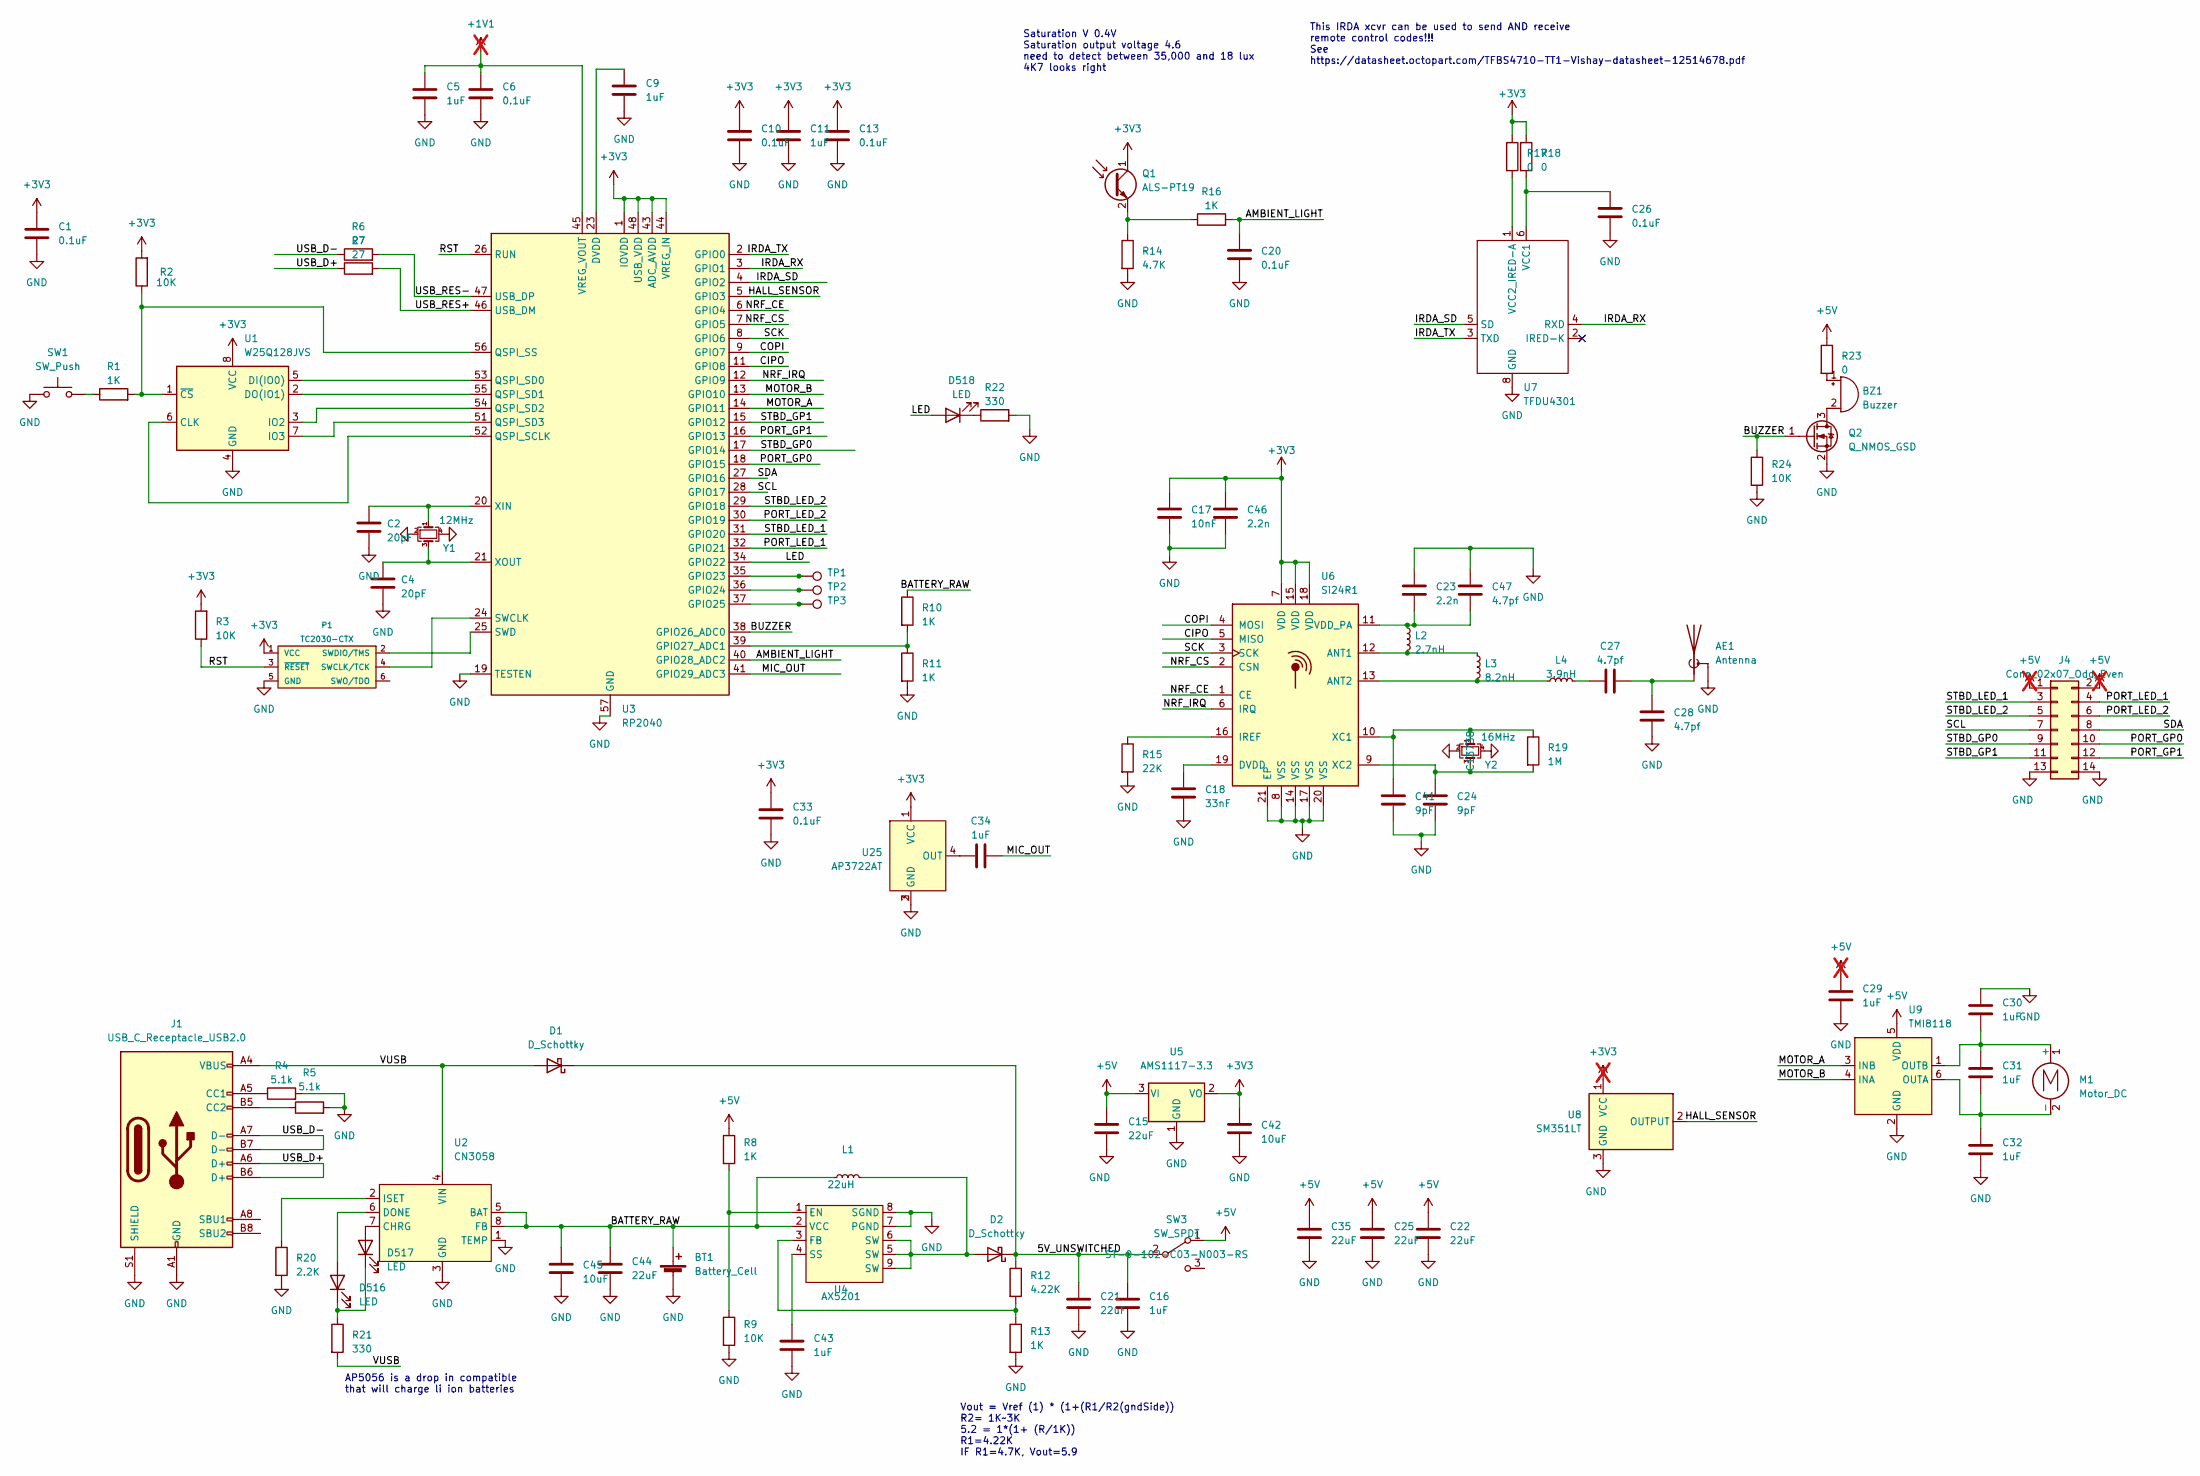
[picture p12: schematic ButterflyBadge.kicad_sch]

Parts:
AE1: Antenna; Texas_SWRA117D_2.4GHz_Left
BT1: Battery_Cell; BatteryHolder_MPD_BH-18650-PC2
BZ1: Buzzer; Buzzer-GSC5025YA-12R4000
C1, C6, C10, C13, C20, C33: 0.1uF; C_0402_1005Metric; LCSC C307331
C2, C4: 20pF; C_0402_1005Metric; LCSC C1554
C5, C9, C11, C16, C29, C30, C31, C32, C34, C43: 1uF; C_0402_1005Metric; LCSC C52923
C15, C21, C22, C25, C35, C44: 22uF; C_1206_3216Metric; LCSC C12891
C17: 10nF; C_0402_1005Metric; LCSC C15195
C18: 33nF; C_0402_1005Metric; LCSC C1585
C23, C46: 2.2n; C_0402_1005Metric; LCSC C1531
C24, C41: 9pF; C_0402_1005Metric; LCSC C32949
C26: 0.1uF; C_0603_1608Metric; LCSC C307331
C27, C28, C47: 4.7pf; C_0402_1005Metric; LCSC C1569
C42, C45: 10uF; C_0603_1608Metric; LCSC C96446
D1, D2: D_Schottky; D_SMA; LCSC C8678
D516, D517, D518: LED; LED_0603_1608Metric; LCSC C2286
J1: USB_C_Receptacle_USB2.0; USB_C_Receptacle_HRO_TYPE-C-31-M-12
J4: Conn_02x07_Odd_Even; FlatFlexWingConnector-PCBSide
L1: 22uH; YSPI0630A; LCSC C497873
L2: 2.7nH; L_0402_1005Metric; LCSC C14033
L3: 8.2nH; L_0402_1005Metric; LCSC C27147
L4: 3.9nH; L_0402_1005Metric; LCSC C14033
M1: Motor_DC; JST_XH_B2B-XH-AM_1x02_P2.50mm_Vertical
P1: TC2030-CTX; TC2030-MCP-NL
Q1: ALS-PT19; R_0402_1005Metric; Manufacturer PN ALS-PT19-315C/L177/TR8; LCSC C146233
Q2: Q_NMOS_GSD; SOT-23; LCSC C8545
R1, R8, R10, R11, R13, R16: 1K; R_0402_1005Metric; LCSC C11702
R2, R3, R9, R24: 10K; R_0402_1005Metric; LCSC C25744
R4, R5: 5.1k; R_0402_1005Metric; LCSC C25905
R6, R7: 27; R_0402_1005Metric; LCSC C25105
R12: 4.22K; R_0402_1005Metric; LCSC C25900
R14: 4.7K; R_0402_1005Metric; LCSC C25900
R15: 22K; R_0402_1005Metric; LCSC C25768
R17, R18, R23: 0; R_0402_1005Metric; LCSC C17168
R19: 1M; R_0402_1005Metric; LCSC C26083
R20: 2.2K; C_0402_1005Metric; LCSC C25879
R21, R22: 330; C_0402_1005Metric; LCSC C25104
SW1: SW_Push; SW_SPST_EVPBF; LCSC C318884
SW3: SW_SPDT; SW_Push_1P2T_Vertical_E-Switch_800UDP8P1A1M6; Manufacturer PN ST-0-102-C03-N003-RS
TP1, TP2, TP3: TestPoint_Pad_D1.0mm
U1: W25Q128JVS; SOIC-8_5.23x5.23mm_P1.27mm; LCSC C97521
U2: CN3058; SOP-8_3.9x4.9mm_P1.27mm; LCSC CN3058E
U3: RP2040; QFN-56-1EP_7x7mm_P0.4mm_EP3.2x3.2mm; LCSC C2040
U4: AX5201; SOIC-8-1EP_3.9x4.9mm_P1.27mm_EP2.41x3.3mm_ThermalVias; LCSC C211668
U5: AMS1117-3.3; SOT-223-3_TabPin2; LCSC C6186
U6: Si24R1; QFN-20-1EP_4x4mm_P0.5mm_EP2.5x2.5mm; LCSC C14436
U7: TFDU4301; LCSC C222418
U8: SM351LT; SOT-23; LCSC C285995
U9: TMI8118; SOT-23-6; LCSC C840556
U25: AP3722AT; LCSC C918198
Y1: 12MHz; Crystal_SMD_3225-4Pin_3.2x2.5mm; LCSC C9002
Y2: 16MHz; Crystal_SMD_3225-4Pin_3.2x2.5mm; LCSC C13738

Connections:
+1V1: C5.1, C6.1, U3.45 (VREG_VOUT)
+3V3: C1.1, C10.1, C11.1, C13.1, C17.1, C33.1, C42.1, C46.1, P1.1 (VCC), Q1.1 (C), R2.2, R3.2, R17.1, R18.1, U1.8 (VCC), U3.1 (IOVDD), U3.10 (IOVDD), U3.22 (IOVDD), U3.33 (IOVDD), U3.42 (IOVDD), U3.43 (ADC_AVDD), U3.44 (VREG_IN), U3.48 (USB_VDD), U3.49 (IOVDD), U5.2 (VO), U6.7 (VDD), U6.15 (VDD), U6.18 (VDD), U8.1 (VCC), U25.1 (VCC)
+5V: C15.1, C22.1, C25.1, C29.1, C35.1, J4.1, J4.2, R8.1, R23.1, SW3.1 (A), U5.3 (VI), U9.5 (VDD)
/5V_UNSWITCHED: C16.1, C21.1, D1.1 (K), D2.1 (K), R12.1, SW3.2 (B)
/AMBIENT_LIGHT: C20.1, R16.2, U3.40 (GPIO28_ADC2)
/BATTERY_RAW: BT1.1 (+), C44.1, C45.1, L1.1, R10.1, U2.5 (BAT), U2.8 (FB), U4.2 (VCC)
/BUZZER: Q2.1 (G), R24.1, U3.38 (GPIO26_ADC0)
/CIPO: U3.11 (GPIO8), U6.5 (MISO)
/COPI: U3.9 (GPIO7), U6.4 (MOSI)
/HALL_SENSOR: U3.5 (GPIO3), U8.2 (OUTPUT)
/IRDA_RX: U3.3 (GPIO1), U7.4 (RXD)
/IRDA_SD: U3.4 (GPIO2), U7.5 (SD)
/IRDA_TX: U3.2 (GPIO0), U7.3 (TXD)
/LED: D518.2 (A), U3.34 (GPIO22)
/MIC_OUT: C34.2, U3.41 (GPIO29_ADC3)
/MOTOR_A: U3.14 (GPIO11), U9.3 (INB)
/MOTOR_B: U3.13 (GPIO10), U9.4 (INA)
/NRF_CE: U3.6 (GPIO4), U6.1 (CE)
/NRF_CS: U3.7 (GPIO5), U6.2 (CSN)
/NRF_IRQ: U3.12 (GPIO9), U6.6 (IRQ)
/PORT_GP0: J4.10, U3.18 (GPIO15)
/PORT_GP1: J4.12, U3.16 (GPIO13)
/PORT_LED_1: J4.4, U3.32 (GPIO21)
/PORT_LED_2: J4.6, U3.30 (GPIO19)
/RST: P1.3 (~RESET), R3.1, U3.26 (RUN)
/SCK: U3.8 (GPIO6), U6.3 (SCK)
/SCL: J4.7, U3.28 (GPIO17)
/SDA: J4.8, U3.27 (GPIO16)
/STBD_GP0: J4.9, U3.17 (GPIO14)
/STBD_GP1: J4.11, U3.15 (GPIO12)
/STBD_LED_1: J4.3, U3.31 (GPIO20)
/STBD_LED_2: J4.5, U3.29 (GPIO18)
/USB_D+: J1.A6 (D+), J1.B6 (D+), R7.1
/USB_D-: J1.A7 (D-), J1.B7 (D-), R6.1
/USB_RES+: R7.2, U3.46 (USB_DM)
/USB_RES-: R6.2, U3.47 (USB_DP)
/VUSB: D1.2 (A), J1.A4 (VBUS), J1.A9 (VBUS), J1.B4 (VBUS), J1.B9 (VBUS), R21.2, U2.4 (VIN)
GND: AE1.2 (Shield), BT1.2 (-), C1.2, C2.2, C4.2, C5.2, C6.2, C9.2, C10.2, C11.2, C13.2, C15.2, C16.2, C17.2, C18.2, C20.2, C21.2, C22.2, C23.1, C24.2, C25.2, C26.2, C28.1, C29.2, C30.1, C32.2, C33.2, C35.2, C41.2, C42.2, C43.2, C44.2, C45.2, C46.2, C47.2, J1.A1 (GND), J1.A12 (GND), J1.B1 (GND), J1.B12 (GND), J1.S1 (SHIELD), J4.13, J4.14, P1.5 (GND), Q2.2 (S), R4.2, R5.2, R9.2, R11.2, R13.2, R14.2, R15.2, R20.2, R22.2, R24.2, SW1.1, U1.4 (GND), U2.1 (TEMP), U2.3 (GND), U3.19 (TESTEN), U3.57 (GND), U4.7 (PGND), U4.8 (SGND), U5.1 (GND), U6.8 (VSS), U6.14 (VSS), U6.17 (VSS), U6.20 (VSS), U6.21 (EP), U7.8 (GND), U8.3 (GND), U9.2 (GND), U25.2 (GND), U25.3 (GND), Y1.2, Y1.4, Y2.2, Y2.4
unnamed: AE1.1 (A), C27.2, C28.2
unnamed: BZ1.2 (+), Q2.3 (D)
unnamed: BZ1.1 (-), R23.2
unnamed: C27.1, L4.2
unnamed: D2.2 (A), L1.2, U4.5 (SW), U4.6 (SW), U4.9 (SW)
unnamed: D516.2 (A), U2.6 (DONE)
unnamed: D516.1 (K), D517.1 (K), R21.1
unnamed: D517.2 (A), U2.7 (CHRG)
unnamed: D518.1 (K), R22.1
unnamed: J1.A5 (CC1), R4.1
unnamed: J1.B5 (CC2), R5.1
unnamed: C30.2, C31.1, M1.1 (+), U9.1 (OUTB)
unnamed: C31.2, C32.1, M1.2 (-), U9.6 (OUTA)
unnamed: P1.4 (SWCLK/TCK), U3.24 (SWCLK)
unnamed: P1.2 (SWDIO/TMS), U3.25 (SWD)
unnamed: Q1.2 (E), R14.1, R16.1
unnamed: R1.1, SW1.2
unnamed: U1.6 (CLK), U3.52 (QSPI_SCLK)
unnamed: U1.5 (DI(IO0)), U3.53 (QSPI_SD0)
unnamed: U1.2 (DO(IO1)), U3.55 (QSPI_SD1)
unnamed: U1.3 (IO2), U3.54 (QSPI_SD2)
unnamed: U1.7 (IO3), U3.51 (QSPI_SD3)
unnamed: R1.2, R2.1, U1.1 (~CS), U3.56 (QSPI_SS)
unnamed: R20.1, U2.2 (ISET)
unnamed: C9.1, U3.23 (DVDD), U3.50 (DVDD)
unnamed: TP1.1, U3.35 (GPIO23)
unnamed: TP2.1, U3.36 (GPIO24)
unnamed: TP3.1, U3.37 (GPIO25)
unnamed: R10.2, R11.1, U3.39 (GPIO27_ADC1)
unnamed: C2.1, U3.20 (XIN), Y1.1
unnamed: C4.1, U3.21 (XOUT), Y1.3
unnamed: R8.2, R9.1, U4.1 (EN)
unnamed: R12.2, R13.1, U4.3 (FB)
unnamed: C43.1, U4.4 (SS)
unnamed: L2.2, L3.1, U6.12 (ANT1)
unnamed: L3.2, L4.1, U6.13 (ANT2)
unnamed: C18.1, U6.19 (DVDD)
unnamed: R15.1, U6.16 (IREF)
unnamed: C23.2, C47.1, L2.1, U6.11 (VDD_PA)
unnamed: C41.1, R19.1, U6.10 (XC1), Y2.1
unnamed: C24.1, R19.2, U6.9 (XC2), Y2.3
unnamed: C26.1, R18.2, U7.6 (VCC1)
unnamed: R17.2, U7.1 (VCC2_IRED-A)
unnamed: C34.1, U25.4 (OUT)

Notes on the sheet:
Vout = Vref (1) * (1+(R1/R2(gndSide)) R2= 1K~3K 5.2 = 1*(1+ (R/1K)) R1=4.22K IF R1=4.7K, Vout=5.9
AP5056 is a drop in compatible that will charge li ion batteries
This IRDA xcvr can be used to send AND receive remote control codes!!! See https://datasheet.octopart.com/TFBS4710-TT1-Vishay-datasheet-12514678.pdf
Saturation V 0.4V Saturation output voltage 4.6 need to detect between 35,000 and 18 lux 4K7 looks right

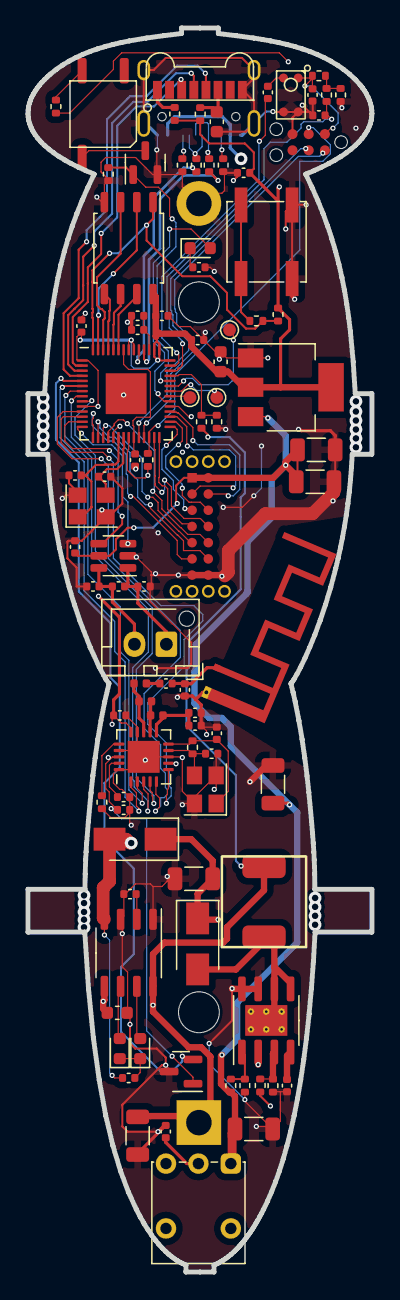
[picture p13: board ButterflyBadge.kicad_pcb from above]

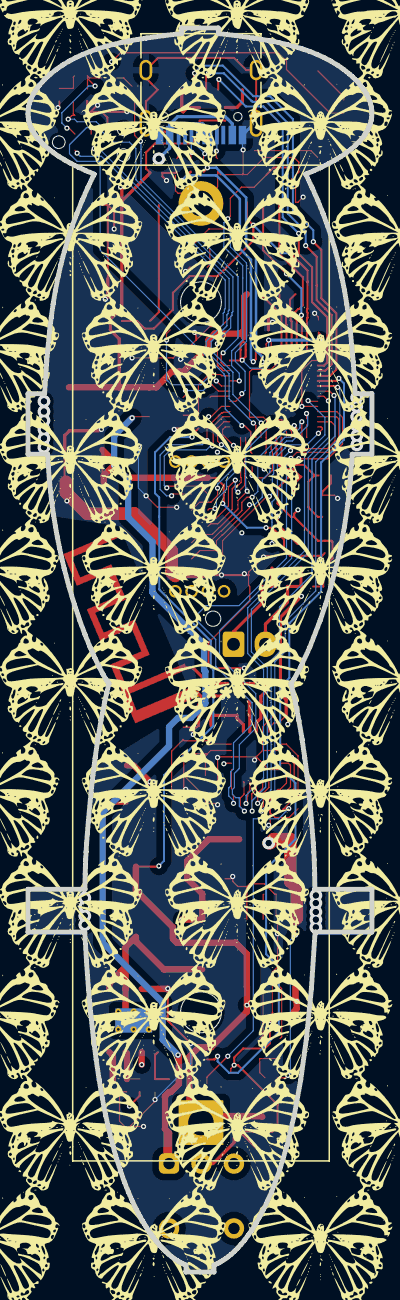
[picture p14: board ButterflyBadge.kicad_pcb from below]

Board: 4 copper layers, 26.9 x 97.4 mm, 95 parts (2 on the bottom side), 82 nets.
