cculpepper/ButterflyBadge/(commit log)

2022-09-13 Initial hardware commit
    [ButterflyBadge.kicad_pcb, ButterflyBadge.kicad_sch]
2022-09-16 fixed frame repainting and added ide files to gitignore
    [main.rs]
2022-09-16 Finished the power section
    [ButterflyBadge.kicad_sch]
2022-09-17 More hardware work
    [ButterflyBadge.kicad_sch]
2022-09-21 More schetaic work
    [ButterflyBadge.kicad_sch, LeftWing.kicad_sch, p.kicad_sch]
2022-09-22 Main schematic is done?
    [ButterflyBadge.kicad_sch, PortWing.kicad_sch, StbdWing.kicad_sch]
2022-09-24 refactor led generation code to use iterators
2022-09-25 added led counter
2022-09-30 Schematic is done! Now to work on the main PCB
    [ButterflyBadge.kicad_pcb, ButterflyBadge.kicad_sch, PortWing.kicad_sch, StbdWing.kicad_sch]
2022-10-02 added save to svg button
2022-10-04 Pulled in wing half
2022-10-04 More schematic and PCB work Bang
    [ButterflyBadge.kicad_pcb, ButterflyBadge.kicad_sch, PortWing.kicad_sch, StbdWing.kicad_sch, outline.FCStd]
2022-10-10 Hardware mods
    [ButterflyBadge.kicad_pcb, ButterflyBadge.kicad_sch, PortWing.kicad_sch, StbdWing.kicad_sch, WingTest.FCStd, wing-Test.kicad_pcb]
2022-10-11 Almost had the PCB done, need to restart. Sad face
    [ButterflyBadge.kicad_pcb, ButterflyBadge.kicad_sch, StbdWing.kicad_sch]
2022-10-13 Component placement is done, now for layout
    [ButterflyBadge.kicad_pcb, ButterflyBadge.kicad_sch]
2022-10-13 Commit before I try to ripup everything on a whim
    [ButterflyBadge.kicad_pcb, ButterflyBadge.kicad_sch]
2022-10-14 More routing
    [ButterflyBadge.kicad_pcb, ButterflyBadge.kicad_sch]
2022-10-14 Routing done, next is error checking and assembly
    [ButterflyBadge.kicad_pcb]
2022-10-14 Commit before changing board outline
    [ButterflyBadge-B_Cu.gbl, ButterflyBadge-B_Mask.gbs, ButterflyBadge-B_Paste.gbp, ButterflyBadge-B_Silkscreen.gbo, ButterflyBadge-Edge_Cuts.gm1, ButterflyBadge-F_Cu.gtl, ButterflyBadge-F_Mask.gts, ButterflyBadge-F_Paste.gtp]
2022-10-18 Placed all the stbd wing leds
    [ButterflyBadge-B_Cu.gbl, ButterflyBadge-B_Mask.gbs, ButterflyBadge-B_Paste.gbp, ButterflyBadge-B_Silkscreen.gbo, ButterflyBadge-Edge_Cuts.gm1, ButterflyBadge-F_Cu.gtl, ButterflyBadge-F_Mask.gts, ButterflyBadge-F_Paste.gtp]
2022-10-19 Routing done
    [StarboardWing.FCStd]
2022-10-20 Started the port wing, was able to pull locations from starboard
    [PortWing.kicad_pcb, PortWing.kicad_sch, PortWingTest.kicad_pcb]
2022-10-20 Re-moved everything
    [PortWing.kicad_sch, StarboardWing.kicad_sch]
2022-10-22 Released boards to manufacture
    [PortWing-B_Cu.gbr, PortWing-B_Mask.gbr, PortWing-B_Paste.gbr, PortWing-Edge_Cuts.gbr, PortWing-F_Cu.gbr, PortWing-F_Fab.gbr, PortWing-F_Mask.gbr, PortWing-F_Paste.gbr]
2022-10-22 Added BOMs
    [BOM-JLCPCB.csv, ButterflyBadge.csv, PortWing.csv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]
2022-10-25 Added new port wing .zip
    [PortWing-B_Cu.gbr, PortWing-B_Mask.gbr, PortWing-B_Paste.gbr, PortWing-Edge_Cuts.gbr, PortWing-F_Cu.gbr, PortWing-F_Fab.gbr, PortWing-F_Mask.gbr, PortWing-F_Paste.gbr]
2022-11-01 Added second wing
2022-11-07 Added LED positions
    [LED_Positions.csv]
2022-11-07 Added gif generator
    [LED_Positions.csv]
2022-11-07 Updated sizing on frames
2022-11-28 Started working on a hinge
    [wingHinge.FCStd]
2022-11-29 Added gif code, worked on the 3d printed hinges'
    [wingHinge.FCStd]
2022-11-30 Switched to rainbow
2022-12-01 this might have broke it, sorry >_<
    [main.rs]
2022-12-04 Added hinges, changed runner
    [centerHinge.FCStd, hingeTestAssembly.FCStd, wingHinge.FCStd]
